zimolab/rk3506-mipi-lcd/docs/SCH_Schematic_luckfox_lyra_1-LCD_driver_2025-09-14.png

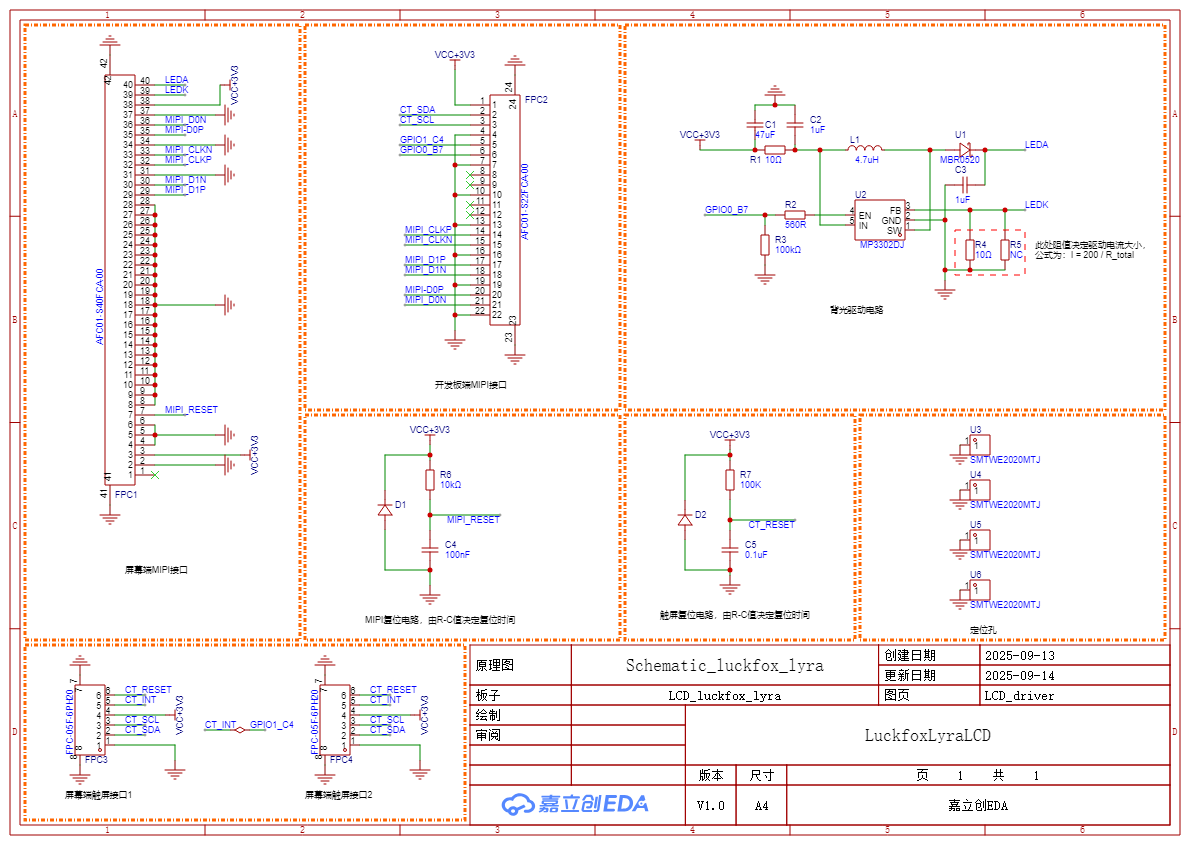
docs/SCH_Schematic_luckfox_lyra_1-LCD_driver_2025-09-14.png
