zimolab/rk3506-mipi-lcd/(list of files, drawings)

Other design files:
hardware/ProPrj_LuckfoxLyraLCD_2025-09-14.epro
