zimolab/rk3506-mipi-lcd/(commit log)

2025-09-14 init commit
    [ProPrj_LuckfoxLyraLCD_2025-09-14.epro]
2025-09-14 update pcb project
    [ProPrj_LuckfoxLyraLCD_2025-09-14.epro]
